timoskis/CapstoneProject/MyProject/Final Build.JPG

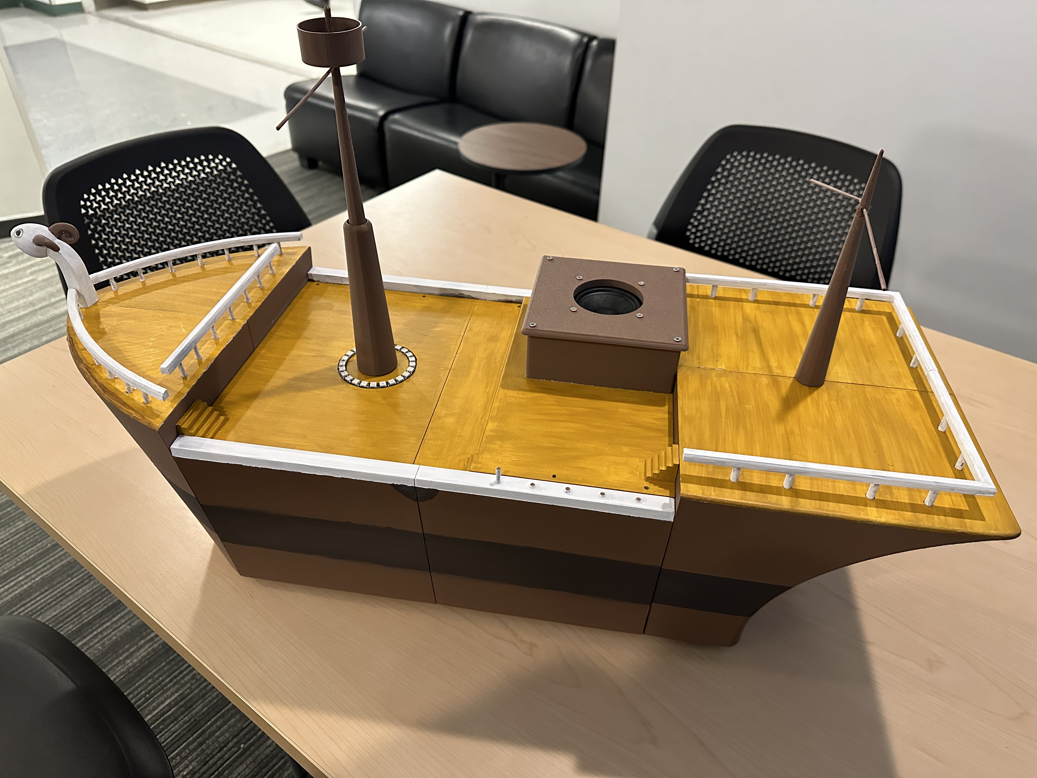
MyProject/Final Build.JPG
