timoskis/CapstoneProject/MyProject/Populated PCB.jpg

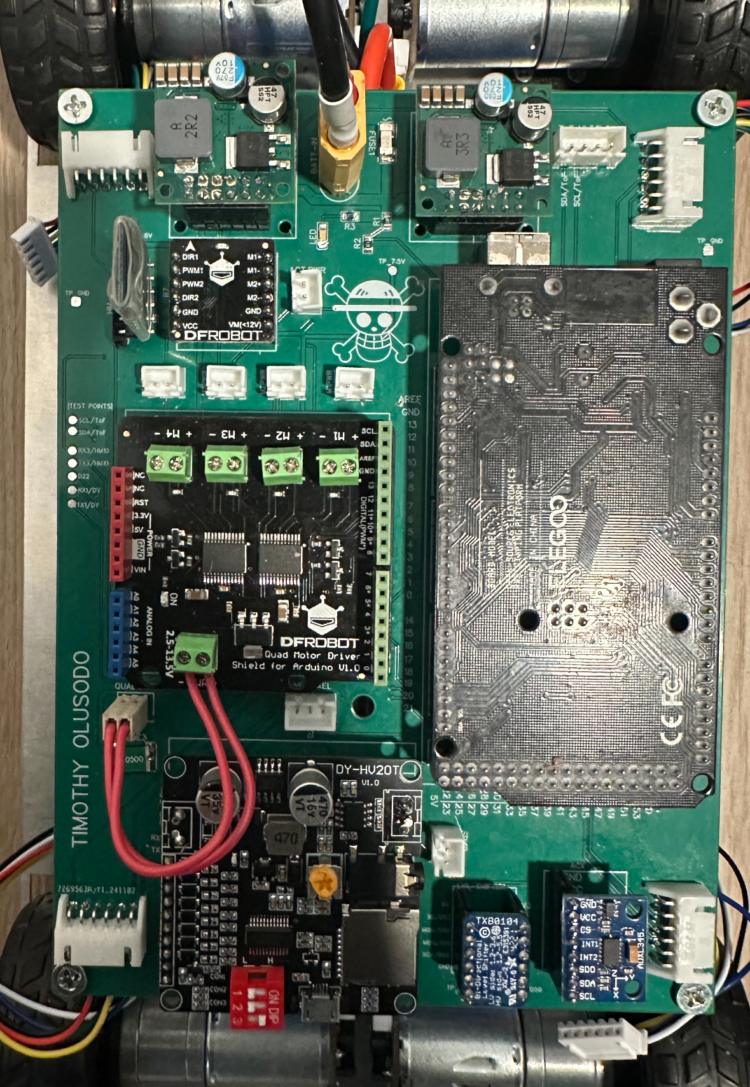
MyProject/Populated PCB.jpg
