timoskis/CapstoneProject/MyProject/PCB_Back.JPG

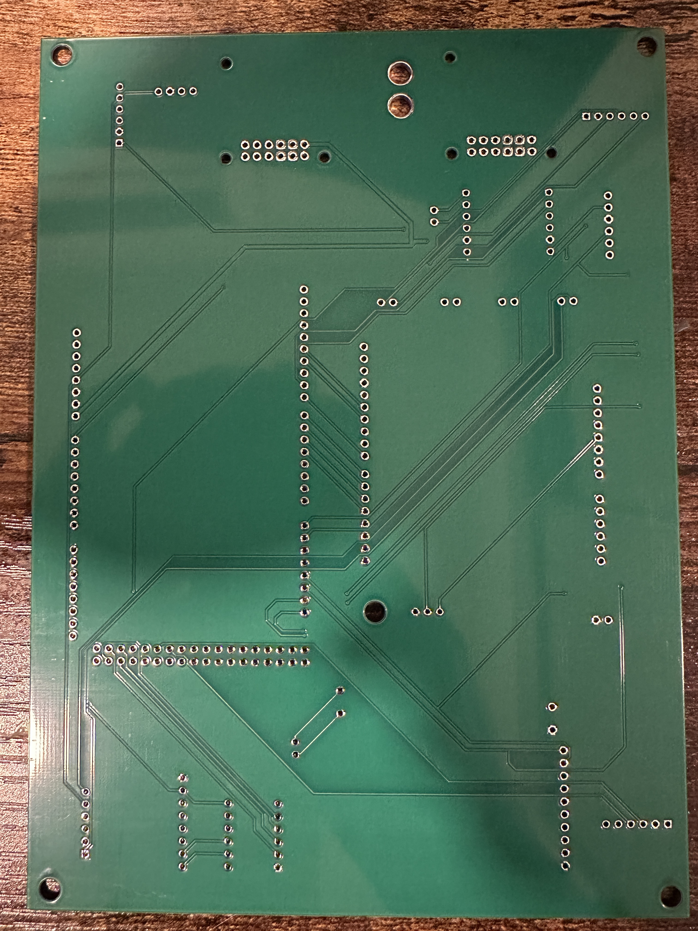
MyProject/PCB_Back.JPG
