timoskis/CapstoneProject/MyProject/PCB_Front.JPG

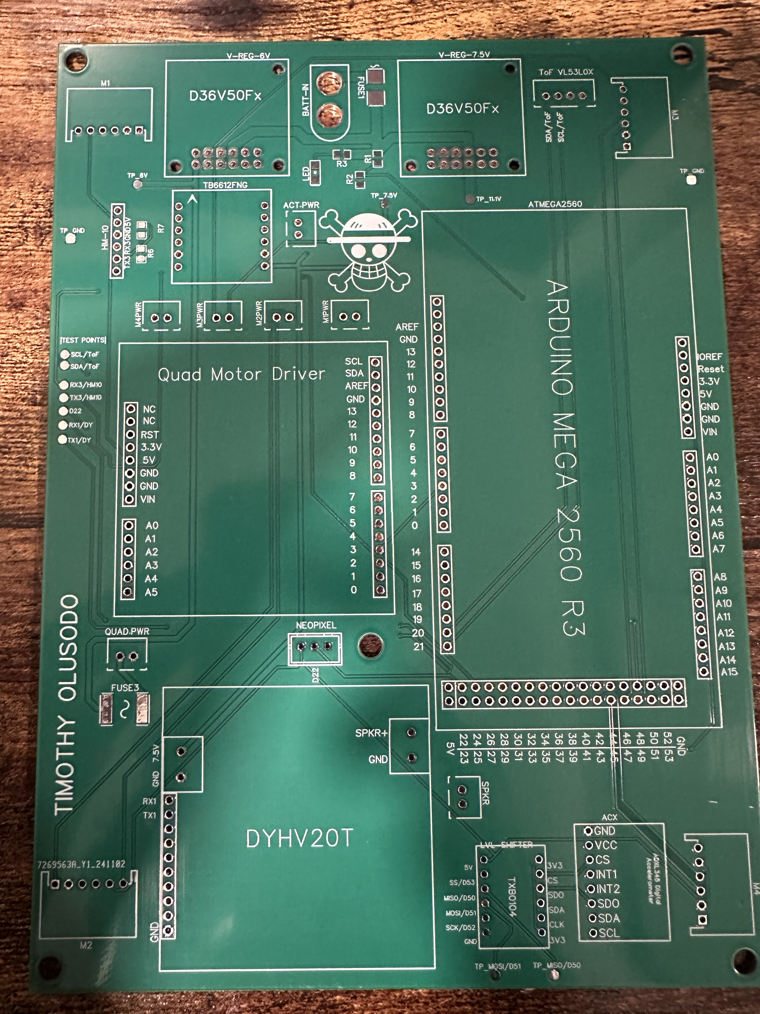
MyProject/PCB_Front.JPG
