timoskis/CapstoneProject/MyProject/PCB_Shot.png

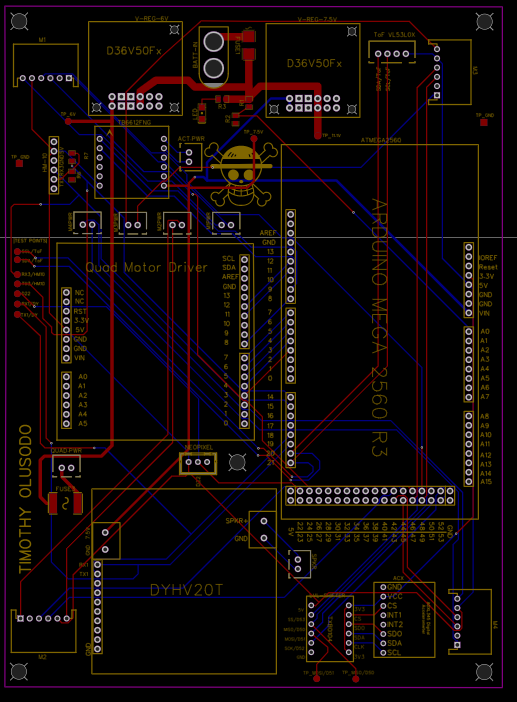
MyProject/PCB_Shot.png
